wizlab-it/temperature-monitor/TemperatureMonitor-DS18B20/PCB/TemperatureMonitor-DS18B20.png

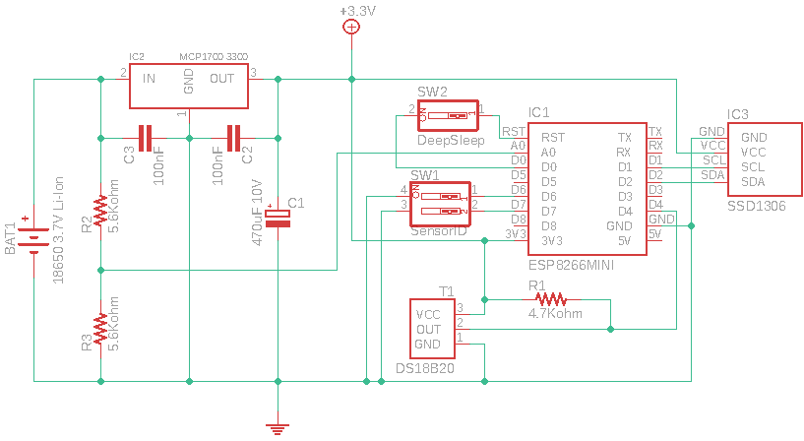
TemperatureMonitor-DS18B20/PCB/TemperatureMonitor-DS18B20.png
