wizlab-it/temperature-monitor/TemperatureMonitor-NTC/PCB/TemperatureMonitor-NTC.png

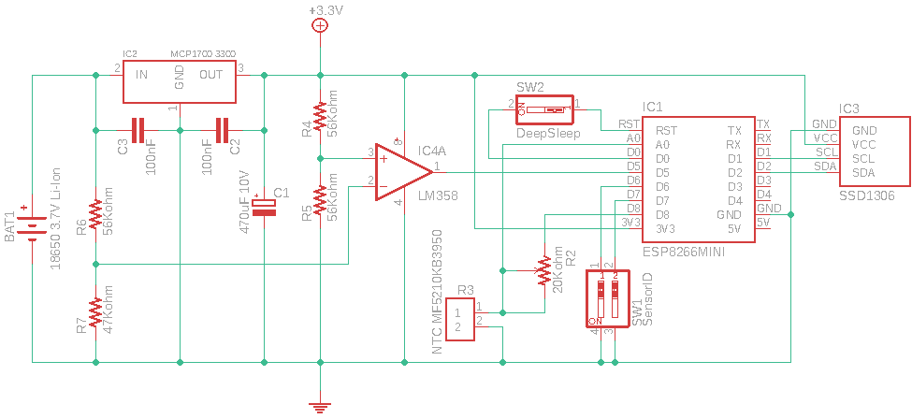
TemperatureMonitor-NTC/PCB/TemperatureMonitor-NTC.png
