wizlab-it/temperature-monitor/TemperatureMonitor-DS18B20/PCB/TemperatureMonitor-DS18B20.sch

## EAGLE design TemperatureMonitor-DS18B20/PCB/TemperatureMonitor-DS18B20.sch (2025-03-12)

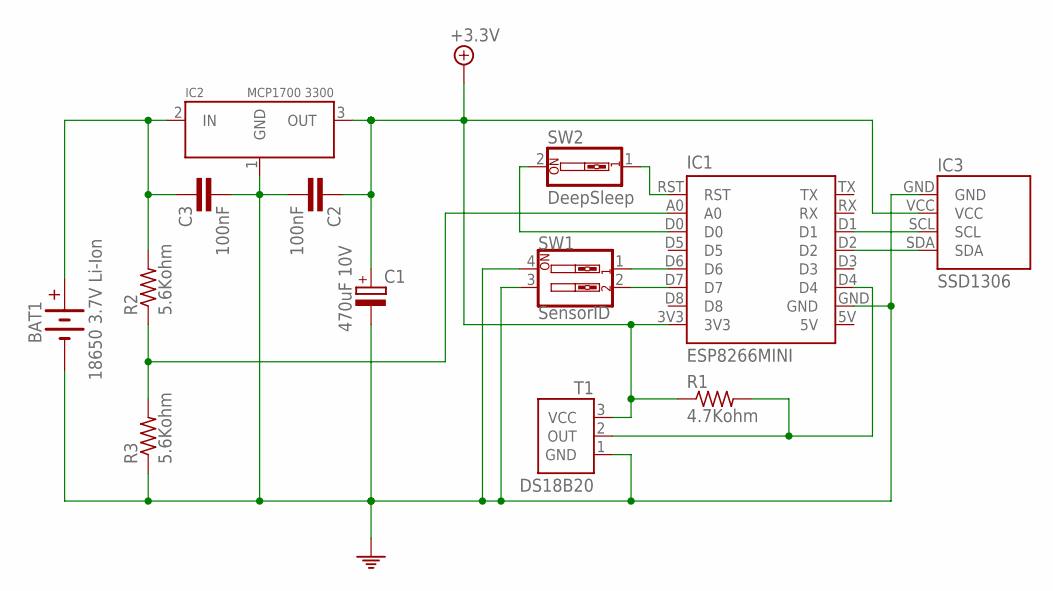
[picture p3: schematic TemperatureMonitor-DS18B20.sch]

Parts:
BAT1: 18650 3.7V Li-Ion; SIL2
C1: 470uF 10V; CAPACITOR-5MM
C2, C3: 100nF; CAPACITOR-5MM
IC1: ESP8266MINI
IC2: MCP1700 3300; TO92
IC3: SSD1306
R1: 4.7Kohm; RESISTOR-0.25W
R2, R3: 5.6Kohm; RESISTOR-0.25W
SW1: SensorID; DIL4
SW2: DeepSleep; DIL2
T1: DS18B20; TO92

Connections:
+3.3V: C1.1, C2.1, IC1.3V3, IC2.3 (OUT), IC3.VCC, R1.1, T1.3 (VCC)
GND: BAT1.2 (-), C1.2, C2.2, C3.1, IC1.GND, IC2.1 (GND), IC3.GND, R3.1, SW1.3, SW1.4, T1.1 (GND)
unnamed: IC1.D2, IC3.SDA
unnamed: IC1.D1, IC3.SCL
unnamed: BAT1.1 (+), C3.2, IC2.2 (IN), R2.2
unnamed: IC1.RST, SW2.1
unnamed: IC1.D7, SW1.2
unnamed: IC1.D6, SW1.1
unnamed: IC1.D4, R1.2, T1.2 (OUT)
unnamed: IC1.A0, R2.1, R3.2
unnamed: IC1.D0, SW2.2
