wizlab-it/temperature-monitor/TemperatureMonitor-NTC/PCB/TemperatureMonitor-NTC.sch

## EAGLE design TemperatureMonitor-NTC/PCB/TemperatureMonitor-NTC.sch (2025-02-13)

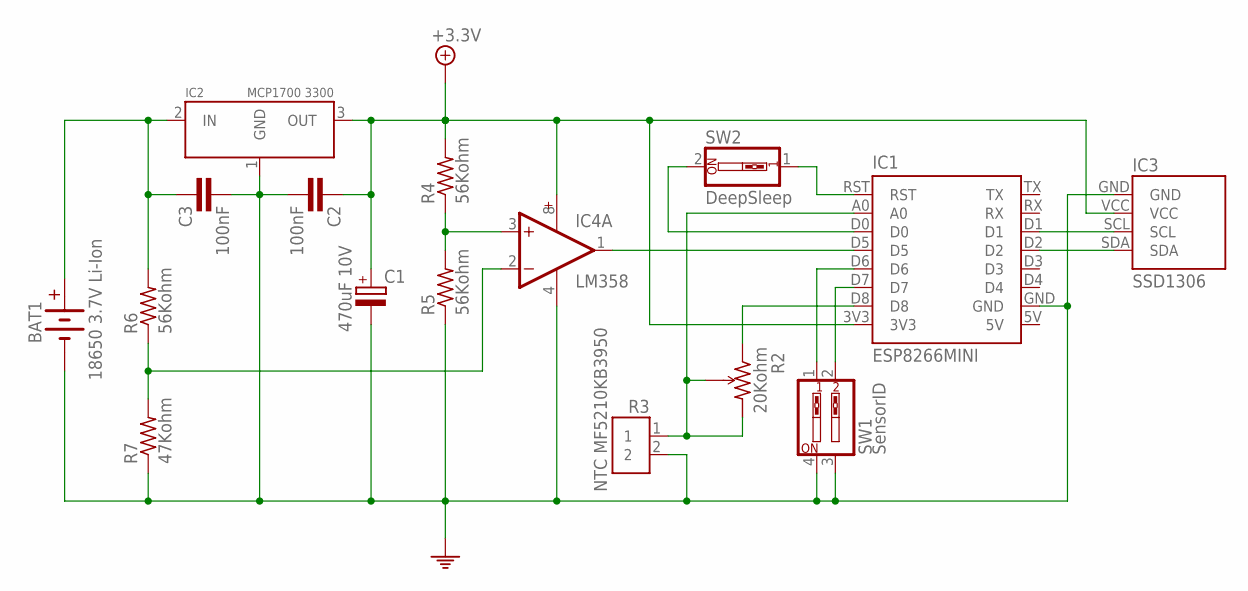
[picture p4: schematic TemperatureMonitor-NTC.sch]

Parts:
BAT1: 18650 3.7V Li-Ion; SIL2
C1: 470uF 10V; CAPACITOR-5MM
C2, C3: 100nF; CAPACITOR-5MM
IC1: ESP8266MINI
IC2: MCP1700 3300; TO92
IC3: SSD1306
IC4: LM358; DIL8
R2: 20Kohm; TRIMMER-A
R3: NTC MF5210KB3950; JST2
R4, R5, R6: 56Kohm; RESISTOR-0.25W
R7: 47Kohm; RESISTOR-0.25W
SW1: SensorID; DIL4
SW2: DeepSleep; DIL2

Connections:
+3.3V: C1.1, C2.1, IC1.3V3, IC2.3 (OUT), IC3.VCC, IC4.8 (V+), R4.2
GND: BAT1.2 (-), C1.2, C2.2, C3.1, IC1.GND, IC2.1 (GND), IC3.GND, IC4.4 (V-), R3.2, R5.1, R7.1, SW1.3, SW1.4
unnamed: IC1.D2, IC3.SDA
unnamed: IC1.D1, IC3.SCL
unnamed: BAT1.1 (+), C3.2, IC2.2 (IN), R6.2
unnamed: IC1.RST, SW2.1
unnamed: IC1.D8, R2.A
unnamed: IC1.D7, SW1.2
unnamed: IC1.A0, R2.B, R2.C, R3.1
unnamed: IC1.D6, SW1.1
unnamed: IC4.3 (+IN), R4.1, R5.2
unnamed: IC4.2 (-IN), R6.1, R7.2
unnamed: IC1.D5, IC4.1 (OUT)
unnamed: IC1.D0, SW2.2
