wizlab-it/temperature-monitor/(commit log)

2024-01-14 Added option to send a telegram alert when temperature is out-of-range, minor fixes
2024-01-26 General improvements and fixes in the code; low-battery level notification added; documentation improved
    [TemperatureMonitor.ino]
2025-02-13 Added support for DS18B20 temperature sensor
    [TemperatureMonitor-DS18B20.sch, TemperatureMonitor-NTC.sch]
2025-03-05 Battery status check via A/D on DS18B20 version
    [TemperatureMonitor-DS18B20.sch]
2025-03-12 Minor changes
    [TemperatureMonitor-DS18B20.sch]
